GERUNSJ/Fuga3D/Configuración/README.md

# Contenido #

1. Cura (3.2.1)
    1. Descripción de la máquina, guardado como proyecto de Cura. Incluye medidas del espacio de impresión y del _hotend_, y gcodes de inicio y finalización. Al momento de escribir esto (Cura 3.3.1), es la única forma de exportar configuraciones de máquina. [Más acá](https://github.com/Ultimaker/Cura/issues/3568)
    2. Perfiles de impresión:
        1. PLA 0,2mm
2. Simplify3D (3.1.1)
    1. COMPLETAR
3. Marlin
    1. COMPLETAR

# CHANGELOG #

* 27/04/2018 - Pablo A
    * Creo este archivo descriptivo del contenido de la carpeta.
    * Subo perfiles de máquina y de PLA 0,2mm para Cura 3.2.1.
    * Actualizo perfil de Simplify
        * Extrusion multiplier = 1.05
        * Infill rectilineo
