GERUNSJ/Fuga3D/(list of files, cad)

Other CAD files:
Configuración/Cura/FUGA3D--maquina.curaproject.3mf
