GERUNSJ/Fuga3D/(threads)

Thread 1 (2017-07-01):

Breve explicación en Readme

aguadopd, 2017-07-01:
El Readme debería tener una breve referencia al proyecto. Qué es.

german-e-mas, 2017-07-01:
Haría una breve explicación y una guía de uso.

aguadopd, 2017-07-01:
@german-e-mas Tenía la duda de si es mejor tener todo en el Readme o hacer una wiki más segmentada.

german-e-mas, 2017-07-01:
El readme debería tener información concreta (instalá este programa, usala así, etc) con links a info más detallada.

Igual, desconozco qué links e información se podrían usar...

german-e-mas, 2017-09-22:
@aguadopd listá las observaciones que hicieron, así las tenemos en cuenta para futuros trabajos.

Thread 3 (2017-07-01):

Wiki del projecto

german-e-mas, 2017-07-01:
Cómo nació la Fuga y su gemela. Quiénes estuvieron involucrados. Qué se hizo.

[idea] Links de noticias y cosas relacionadas.

aguadopd, 2017-07-01:
@german-e-mas ¿noticias como "Cambiamos el final de carrera"? No entendí lo de links. Si es eso que digo, podría estar directamente en Home. Un changelog

german-e-mas, 2017-07-01:
Decía por si los chicos tenían algún link de diarios o algo por el estilo, donde hayan salido noticias de la Fuga. Estaría bueno documentar todo eso y me pareció bueno hacerlo en la Wiki. Sólo una idea.

En cuanto a links, diría tutoriales y cosas útiles para saber usarla. Si alguien se mete al grupo y quiere usar la impresora, que pueda venir a esta Wiki y tener algo de idea.

Thread 4 (2017-07-07):

Fin de carrera eje Z: cambiar cables y/o revisar fin de carrera.

aguadopd, 2017-07-07:
Síntoma ocasional: la impresora debe ir al origen y lo hace en los ejes X e Y, pero no en Z. Si le das manualmente _Ir al origen_, en Z sube un poco desde donde esté.

Creemos que el problema es el cable del fin de carrera, ya que es el mismo problema que ocurría cuando estaba desconectado ese final de carrera. El cable está unido con unos pines a otro cable... una unión bastante cuestionable. Puede ser que esté haciendo falso contacto ahí, o que esté jodido el final de carrera mismo.

german-e-mas, 2017-07-07:
Ocasional? Pasa de vez en cuando? Es muy dificil cambiar todo el cable y el fin de carrera? Creo que sería lo mejor, para despejar cualquier duda.

aguadopd, 2017-07-07:
Pasó 2 veces ya. Pero ahora ajustamos mejor la conexión entre cables. Lo mejor sería cambiar todo el cable o soldar esos cables. Yo creo que es el cable y no el final de carrera.

german-e-mas, 2017-09-22:
Lo cambio a Enhancement: Hay que cambiar el cable en un futuro.

MauroDiamantino, 2018-09-22:
> Pasó 2 veces ya. Pero ahora ajustamos mejor la conexión entre cables. Lo mejor sería cambiar todo el cable o soldar esos cables. Yo creo que es el cable y no el final de carrera.

Alguien hizo alguna de esas propuestas?

Thread 5 (2017-07-07):

Se junta plástico en la parte superior del _nozzle_ del _hotend_

aguadopd, 2017-07-07:
Al parecer la punta cuadrada (_nozzle_), que es por donde sale el plástico y donde se conecta la resistencia calefactora y el termistor, está desajustado, ya que se junta plástico derretido en la superficie superior de ese prisma rectangular.

Desconozco el modelo del _hotend_ y por tanto no puedo dar más detalles.

- [x] Averiguar más con los que saben.

german-e-mas, 2017-09-22:
Se sigue juntando plástico?

aguadopd, 2017-09-22:
Vigente.

Sacamos el _hotend_ entero y no pudimos desajustar el bloque. Al parecer se ha robado el tornillo hueco que conecta las partes (_barrel_).

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
_Nota: nuestro hotend es de metal puro, no tiene tubo de teflón adentro_

La boquilla no ha estado bien ajustada y entonces el plástico caliente se mete por ese espacio, fluye por la rosca y sale por la parte de arriba del bloque. Creo que no podemos ajustar bien la boquilla porque hay plástico en las roscas. Habría que intentar ajustar la boquilla con el _hotend_ caliente, pero estando robado el _barrel_, tal vez convendría comprar un nuevo hotend, entero.

aguadopd, 2017-12-02:
Solucionado con #9.

aguadopd, 2017-12-03:
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
Acá se aprecia un poco mejor el problema que teníamos. En impresiones largas, esas gotas empezaba a tocar la punta y arruinar la impresión, si no se sacaban a tiempo.

Closed 2017-12-02.

Thread 6 (2017-08-04):

Corregir espejado del plano XY

aguadopd, 2017-08-04:
Ver los cubos impresos y el modelo correspondiente.

https://www.thingiverse.com/thing:1278865

german-e-mas, 2017-09-22:
Cual es el estado de este issue? Lo arreglaron?

aguadopd, 2017-09-22:
Entiendo que sí.

german-e-mas, 2017-09-22:
Cierro entonces. Cualquier cosa lo reabrimos.

aguadopd, 2017-09-22:
Entiendo que sí sigue vigente, perdón.

MauroDiamantino, 2018-06-01:
Habría que cambiar el fin de carrera que está mal ubicado y reconfigurar el firmware, así no rabiamos más con esto.

Thread 8 (2017-11-24):

Construir un buen perfil para Cura3D

aguadopd, 2017-11-24:
Necesitamos un perfil de Cura3D para imprimir con confianza y sin muchas modificaciones. ¿Por qué usar Cura 3D? Porque es abierto y me pareció más amigable que Slic3r. Deberíamos dejar de usar Simplify.

Voy haciendo el desarrollo de experimentos por acá: https://github.com/GERUNSJ/Fuga3D/wiki/temp_pruebas_cura

Luego copio aquí las decisiones.

Thread 9 (2017-11-24):

Reemplazar hotend con repuesto

aguadopd, 2017-11-24:
Checho trajo un _hotend_ usado que tenía. Es el mismo modelo que el que está puesto: Hexagon. Lo dejo adentro de la impresora. Tiene la punta rota, así que hay que ponerle la punta vigente.

A hacer:

0. Sacar filamento. Para ello, calentar, extruir un poquito y luego tirar hacia arriba para sacar todo.
1. Calentar hotend actual a xxx °C
2. Agarrar bloque con una pinza y aflojar punta con una llave.
3. Enfriar y sacar hotend. Despegar termistor y resistencia calefactora.
4. Poner nuevo hotend y fijar resistencia y termistor.
5. Calentar bloque y sacar punta.
6. Poner nueva punta vieja.

Con esto solucionamos #7 y #5.

[Acá](https://youtu.be/tDq1Du9gaWM?t=4m50s) hay un poco de información.

aguadopd, 2017-12-02:
Con Julio sacamos filamento. Para ello (siguiendo https://youtu.be/t7ZNByjHgFk?t=2m28s) liberamos el mecanismo que presiona el filamento contra el tornillo moleteado, con el fin de poder tirar o empujar a mano.
Calentamos a 200°, empujamos para que extruya un poco y luego tiramos rápidamente hacia arriba.

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

aguadopd, 2017-12-02:
Con el _hotend_ a 200°C, sostenemos el bloque con una pinza y desajustamos la punta con otra. No es difícil, más sí incómodo.

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

aguadopd, 2017-12-02:
Sacamos el _hotend_, luego de sacar el ventilador que enfría al disipador y el plástico que sostiene al conjunto.
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

aguadopd, 2017-12-02:
La resistencia calefactora y el sensor de temperatura están sujetos al bloque con pegamento de alta temperatura, por lo que es difícil sacarlos. Sacamos el pegamento y escarbamos un poco para sacar el sensor. La resistencia necesitó ayuda mecánica.

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

aguadopd, 2017-12-02:
Suponemos que el tornillo que ajusta el _barrel_ del nuevo _hotend_ está ajustado (si es que hay tornillo). Continuamos así:

1. Colocamos el nuevo _hotend_ en la impresora.
2. Calentamos a 220°C (al parecer lo máximo que se puede llegar antes de que largue un error porque la temperatura no se incrementa --¿thermal rundown?--).
3. Sacamos la punta del _hotend_ nuevo.
4. Ponemos la punta del _hotend_ viejo. Ajustamos bien pero sin ejercer mucha fuerza.

Al parecer lo de calentar a lo máximo posible tolerado por el _hardware_ disponible ayuda a un mejor ajuste por temas de contracción y dilatación. Así se evita que luego aparezcan espacios entre _barrel_ y punta por los cuales se puede filtrar el plástico (ver dibujo en #5).

[Acá](https://youtu.be/tDq1Du9gaWM?t=4m50s) hay una explicación, tiene subtítulos.

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

aguadopd, 2017-12-02:
La punta quedó bien. El único problema ahora es que tanto el sensor como la resistencia calentadora se salen de sus orificios, pero para eso creo nuevo _issue_. Julio hizo una prueba sosteniendo a ambos con cinta (desde sus cables) y reporta una buena impresión sin pérdidas de plástico ---hasta que se salió el sensor---. Así que vamos a suponer que la operación fue exitosa.

Closes #5 #7 #9

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

aguadopd, 2018-04-06:
[Acá](https://www.my-home-fab.de/en/documentations/tutorials/assembling-a-hexagon-hotend) dice que "_Hexagon Hotends tend to be leaky, when they are hot_", y le pone teflón a la rosca. ¿Será la solución? Habría que desarmar todo y limpiarlo. Opto por ajustar nomás.

german-e-mas, 2018-04-06:
Había sido ajustado antes, o no quedó bien ajustado?

Se prueba de nuevo, y sino, teflón.

aguadopd, 2018-04-06:
Al parecer no quedó bien ajustado. Procedimiento a realizar pronto: sacar el hotend de su cubículo y ajustar afuera con 2 pinzas, pero con la resistencia calefactora conectada.

aguadopd, 2018-04-20:
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

Le pusimos teflón a la rosca inferior del _barrel_. Luego la ajustamos con las herramientas que teníamos. El procedimiento no es el correcto porque estamos agarrando el disipador y no el barrel. Sin embargo, no teníamos una llave fina que entre ahí. Agarrar el disipador también ajusta el barrel dentro del disipador, pero podemos hacer fuerza en exceso y dañar la rosca interna del disipador.

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

Ya no junta plástico. Queda resuelto esto y #5.

Closed 2018-04-20.

Thread 10 (2017-12-02):

Tornillo de final de carrera de eje Z está flojo

aguadopd, 2017-12-02:
El tornillo que permite ajustar la altura de final de carrera en el eje Z está flojo, y eso hace que deba calibrarse la altura en cada impresión. Creemos que si mejoramos esto, el ajuste va a ser menos frecuente.

aguadopd, 2017-12-02:
Lo solucionamos con unas vueltas de teflón. Con el uso veremos si fue ha sido una solución efectiva. Dejo abierto esto hasta que lo verifiquemos.

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

MauroDiamantino, 2018-09-22:
> Lo solucionamos con unas vueltas de teflón. Con el uso veremos si fue ha sido una solución efectiva. Dejo abierto esto hasta que lo verifiquemos.
>
> 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

Luego de varias impresiones se comprobó que esta solución ha sido bastante buena, ya que cada vez que se re-niveló la cama se encontró que la nivelación no había cambiado demasiado.

Closed 2018-09-22.

Thread 11 (2017-12-02):

Falta lubricación en varillas

aguadopd, 2017-12-02:
Las varillas roscadas y lisas no fueron lubricadas la última vez que reparamos la impresora (¿julio?). Lleva meses de uso así en seco, y esto acorta la vida útil de la máquina.

aguadopd, 2017-12-02:
Sin haber leído mucho sobre el tema y sin entender mucho tampoco, decido lubricar varillas lisas y roscadas con grasa "vaselidada con siliconas". Veremos si dura.

Acá hay más sobre el tema, aunque medio desordenado e incompleto: http://reprap.org/wiki/Lubrication

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

Closed 2017-12-02.

Thread 12 (2017-12-02):

Resistencia calefactora y sensor de temperatura no están sujetos a bloque de _hotend_

aguadopd, 2017-12-02:
Luego de cambiar partes del _hotend_ (ver #9), la resistencia calefactora y el sensor de temperatura quedaron sueltos en el bloque, y por tanto no se puede imprimir.

Dijo Checho que el tornillo del bloque está robado, por lo que algunas soluciones posibles pueden ser:

- Intentar poner un tornillo del paso correcto. Puede haber en el tarrito de vidrio (mermelada) que tiene cosas de impresora.
- Intentar poner un tornillo de paso más grande que el nominal, así sin roscar nada.
- Hacer una rosca con un macho roscante y poner un tornillo más grande que el nominal
- Sujetar todo con pegamento de alta temperatura.

Esta última opción es la más fácil y la que habíamos hecho antes. No presenta problemas hasta que se quiere sacar todo por alguna razón.

MauroDiamantino, 2018-09-22:
Se solucionaron ambos problemas. La resistencia calefactora se fijó al hotend colocando un tornillo roscachapa de diámetro adecuado, de modo que al enroscarlo fuera haciendo la rosca sobre el hotend. Por otro lado, el sensor de temperatura se fijó con Fastix de alta temperatura (rojo). Luego de varias pruebas, se comprobó que ambos habían quedado adecuadamente fijados.

Closed 2018-09-22.

Thread 13 (2017-12-02):

Revisar alturas (en Z) del carro (eje X)

aguadopd, 2017-12-02:
Hay que ver que el montaje que carga el eje X (por donde corre el extrusor) esté perpendicular a las varillas roscadas, y por tanto paralelo a la cama caliente.

Para ello se deben medir las alturas desde los motores de Z hasta los plásticos negros que mueven al eje X (¿cómo se llaman?). Las alturas deben ser iguales. Esto se puede hacer con una regla.

aguadopd, 2018-04-05:
Revisado el 23/03/2018. Debería ser una tarea de mantenimiento regular.

Closed 2018-04-05.

Thread 14 (2017-12-02):

Cama caliente está sucia

aguadopd, 2017-12-02:
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

De tanto imprimir y tanto aerosol fijador, la cama caliente ha quedado bastante sucia. No importa el factor estético pero sí el funcional: la superficie no es plana por el relieve de aerosol seco.

Se puede limpiar con:

* Agua caliente y jabón
* Limpiavidrios (tal vez para darle un toque final)
* Thinner
* Alcohol

Yo probaría con agua caliente y jabón. Nos faltaría comprar el jabón XD

Fuentes:
- http://www.soliforum.com/post/112182/#p112182
- http://community.robo3d.com/index.php?threads/cleaning-heated-bed.6451/
- http://www.soliforum.com/post/99601/#p99601

PD: Leyendo eso veo que al parecer no deberíamos necesitar tanta temperatura para PLA si estamos usando aerosol. Yo intentaría **sin aerosol** para PLA (con la cama a 60°C) o con aerosol y la cama a 40 °C o menos,.

aguadopd, 2018-04-05:
La limpié el viernes 23/03/2018. Usé un poco de alcohol, agua y jabón que había en el baño. Quedó bien.

Closed 2018-04-05.

Thread 16 (2018-09-22):

Problemas de diseño en la estructura

MauroDiamantino, 2018-09-22:
Se encontraron los siguientes problemas en la estructura de la impresora:

1. Las varillas del eje Z están torcidas.
2. La impresora no está fijada a la estructura cerrada que la contiene.
3. La impresora no se asienta bien sobre el piso de la estructura cerrada.

Discutiendo sobre esto llegamos a la conclusión que el problema central es que la impresora es muy híbrida, es decir tiene piezas de diferentes impresoras comerciales. Por lo tanto, surgió la idea de reimprimir las piezas que fueran necesarias para lograr que quede igual que algún impresora conocida, que sea de algún proyecto abierto, es decir que las piezas estén publicadas en Internet. Luego de investigar se decidió modificar la Fuga basándonos en la Prusa i3 MK3 por su buena fama, la gran cantidad de info que hay sobre ella y porque nos permite usar gran parte de las piezas que ya tiene la Fuga.
Se encontró que hay muchas piezas que tiene ahora la Fuga que servirán para la modificación: Arduino Mega,  placa Ramps 1.4, los 4 drivers de los motores, estructura cuadrada metálica (printer frame), soporte cama y cama, finales de carrera, ejes con bujes del "eje" Z, varillas roscadas del mismo eje, fuente de alimentación, placa LCD y perilla, entre otras cosas.
Aún queda por despejar algunas dudas:
- Los motores que tiene ahora la Fuga servirán con las nuevas piezas?
- El diámetro del hotend es adecuado para el nuevo extrusor de la Prusa i3?
- Servirán las varillas que están debajo de la cama?
- Habría que cambiar las correas?
- Servirán las ejes del "eje" Y?
