GERUNSJ/Fuga3D/(commit log)

2017-07-01 Actualización de Readme
2017-07-01 Configuración para Marlin 1.1.x
    Configuración inicial
    [Configuration.h]
2017-07-01 Configuración para Simplify3D
    Solo fue probada para imprimir un cubo. Basada en la configuración para una Prusa i3 MK2 (ver en http://shop.prusa3d.com/forum/original-prusa-i3-mk2-f23/simplify3d-print-settings-august-30-2016--t938.html )
2017-07-08 Extrusion multiplier en 1,1; anduvo mejor en una impresión rápida de un cubo.
2017-08-04 Límites mínimos para X e Y
    Limito el área de impresión, con el fin de evitar los broches que sostienen el vidrio. No lo probé.
    [Configuration.h]
2017-08-04 Asistente de nivelación de cama
    Ahora se puede nivelar la cama desde la pantalla LCD.
    Más en http://marlinfw.org/docs/gcode/G029-mbl.html
    Hacerlo una vez y guardarlo en EEPROM
    [Configuration.h]
2017-08-04 Comandos de EEPROM en LCD
    Ahora sí funciona..
    [Configuration.h]
2017-08-04 Comentarios paso varillas Z
    [Configuration.h]
2017-08-07 Ajuste límites de impresión
    Ahora los límites son correctos. El volumen de impresión máximo es de 175x175x140 mm, y el origen está desfasado en (15,15,0)mm desde el origen físico determinado por los finales de carrera.
    [Configuration.h]
2017-09-16 Update README.md
    Guía semi-rápida de uso
2017-09-22 Update README.md
    Más detalles en Guía rápida de uso y nueva sección Problemas comunes.
2018-04-27 * Actualizo perfil Simplify * Agrego perfiles de máquina y de impresión para Cura 3.2.1 * Agrego README.md para carpeta de Configuración
    [FUGA3D--maquina.curaproject.3mf]
2018-09-22 Update README.md
    Enlaces agregados. Se extendieron algunas explicaciones. Se eliminó el problema del sensor de temperatura del hotend.
